alltagshack/color16cam/(commit log)

2026-02-26 first steps to migratrate to non-arduino plattform
2026-03-11 a well working platformIO version for esp32-s3 without PSRAM, with OV3660 and SSD1331 RGB OLED on vspi. picture is 240x240 and skaled up to 360x360.
2026-03-12 finetuning finished. a flash and a print processing feature is add via RGB LED.
2026-03-14 bugfix scale. bigger resolution
    [main.cpp]
2026-03-14 after testing with "ESC J n" the 1px line after a "ESC *" image printing is a bug inside the UART printing firmware of the printer itself, I think.
    [main.cpp]
2026-10-06 fix from 64x32 to 128x64 display
    [main.cpp]
2026-10-09 DS1307 lib added and time and date is printed additional.
